xiaotu22/mspm0-ball-balance-car/docs/电赛H题_接线方案_从代码重建.docx

# H题 车载平衡滚球运动控制系统

接 线 方 案
（从固件源码逐条提取，非回忆稿）

主控：MSPM0G3507（逐飞核心板 + 拓展板）
依据：firmware_car\project\user\src\*.c 逐文件核对
整理日期：2026-10-15 修订：2026-10-17（循迹改为七路灰度）

说明：本文档由固件源码反推生成，不依赖任何历史文稿。每个引脚都能在代码里找到出处，并在各表「代码出处」列标明。若实物接法与本文不符，以代码为准 —— 因为最终决定行为的是代码。

# 一、引脚分配总表

模块 | 信号 | MCU 引脚 | 代码宏 | 备注
调试串口 UART0 | TX | A10 | UART0_TX_A10 | 115200，接 USB-TTL 看 printf
| RX | A11 | UART0_RX_A11
K230 视觉 UART2 | TX→K230 | B15 | UART2_TX_B15 | 115200，发命令给 K230
| RX←K230 | B18 | UART2_RX_B18 | ⚠️ 原设计 B16，B16 已确认物理损伤，改走 B18
TB6612 左轮 | PWM | A0 | PWM_TIM_A0_CH0_A0 | 10 kHz
| IN1 | B13 | MOTOR_L_IN1
| IN2 | B12 | MOTOR_L_IN2
TB6612 右轮 | PWM | A1 | PWM_TIM_A0_CH1_A1 | 10 kHz
| IN1 | B2 | MOTOR_R_IN1
| IN2 | A13 | MOTOR_R_IN2
TB6612 STBY | 使能 | （硬件拉高） | 代码不驱动 | ⚠️ 必须外部拉高，否则电机不动
摆杆舵机 | PWM | B3 | PWM_TIM_A1_CH1_B3 | 50 Hz；⚠️ 文件头注释写 B4 是旧值，代码已切 B3
七路灰度循迹 ★当前 | CH1~CH7 | B17 A17 A16 B20 B25 A24 A25 | ir7_pin[7] | 主板灰度口 P14 第 2~8 脚（第 1 脚 B18 被 K230 占）；压黑线=高
（已弃用）六路循迹 | SCL | B8 | SENSOR_6CH_SCL | 幻尔 I2C 0x5C，已拆；代码 LINE_SRC_6CH=0 关掉
OLED SSD1306 | SCL | B6 | OLED_SCL_PIN | 软 I2C；无屏也不死机
| SDA | B5 | OLED_SDA_PIN
编码器 左轮 | A 相 | B10 | ENC_L_A | EXTI 双边沿，4 倍频
| B 相 | B9 | ENC_L_B
编码器 右轮 | A 相 | B11 | ENC_R_A
| B 相 | B7 | ENC_R_B
按键 启动/急停 | — | A30 | KEY_PIN | 上拉，按下=低；空闲短按启动、运行中=急停
按键 模式 + | — | B1 | KEY_MODE_UP | 上拉，按下=低
按键 模式 − | — | B0 | KEY_MODE_DN | 上拉，按下=低
按键 题6目标 | — | A31 | KEY_TGT | 上拉，按下=低；+25px/次
LED / 蜂鸣器 | — | A14 | LED_PIN | ⚠️ 同脚！只钉低，禁止翻转，否则一直响

⚠️ 未接线的模块：QMM01 / CY-Z 陀螺仪（UART1 为 A8/A9）

代码里 qmm01.c 存在，但 main.c 里既没有 qmm01_init() 也没有 qmm01_poll() —— 陀螺仪在当前固件中完全未启用，因此实物可以不接。若将来要用，接 UART1：TX=A8、RX=A9，115200。

# 二、分模块接线明细

## 2.1 电源（最容易出事的一环）

• 舵机走独立 5V，电流余量 ≥3A —— 严禁与逻辑 5V 共用（舵机堵转瞬间会把 MCU 拉复位）。

• 所有电源必须共地：核心板 GND ↔ 拓展板 GND ↔ 电池负极 ↔ 舵机电源负极。

• 电机 VM 接电池正极（7~12V），逻辑 5V/3.3V 由拓展板稳压供给。

• 实测提示：电机满 duty(10000) 时左右轮各约 350 rpm。

## 2.2 TB6612 电机驱动

左轮：PWMA=A0、AIN1=B13、AIN2=B12

右轮：PWMB=A1、BIN1=B2、BIN2=A13

STBY：代码不驱动，必须外部拉高（接 3.3V 或 5V），否则 TB6612 输出全关、电机不动。

⚠️ 换向前必须先刹车 ≥10 ms（MOTOR_REVERSE_BRAKE_MS = 10），这是硬件红线，代码已实现保护。

极性：MOTOR_L_POL = +1、MOTOR_R_POL = +1。即 duty 为正时两轮都前进；右轮不取负。

## 2.3 摆杆舵机

信号线接 B3（TIM_A1_CH1），50 Hz PWM。

脉宽换算：duty = 脉宽(µs) × 10000 ÷ 20000，分辨率 2 µs/LSB。

中位：750 duty（=1500 µs）。软件中位 SERVO_MID_VISION = 1726（落地精标值）。

⚠️ servo.c 第 4 行文件头注释写的是 B4，那是切换前的旧值，第 12 行实际代码已是 B3。以 B3 为准。

## 2.4 七路灰度循迹（当前使用 · 数字量）

【接线】7 根信号线接主板灰度口 P14 的第 2~8 脚 —— 第 1 脚 B18 已被 K230 的 RX 占用，跳过它。

CH1=B17 CH2=A17 CH3=A16 CH4=B20 CH5=B25 CH6=A24 CH7=A25

官方端口表顺序：ADC-B18 / B17 / A17 / A16 / B20 / B25 / A24 / A25（本表取后 7 个）

【极性】压黑线时该路输出【高】电平 —— IR7_ACTIVE_LOW = 0（荣洋 rydz 模块 raw 实测铁证，黑底/黑线/抬高 raw 全 1，白底 raw 全 0）。

【位置】权重 {-3,-2,-1,0,+1,+2,+3}（左负右正），加权均值 ×50 → ±150，与旧六路同量纲。

权重中间那个 0 就是中心通道（CH4）—— 7 路奇数，正好有一路压在线上正中。

【起停线】n ≥ 5 路同时为黑 = 起停胶带，pos 冻结、不算丢线（IR7_TAPE_N = 5）。

【空载安全】7 个脚全做上拉输入 —— 线拔掉时读到高，不会误判成"压线"。

【工程取舍】数字量只有 通/断 两态：单路压线时 pos 只取 0 / ±50 / ±100 / ±150 这 7 个值，相邻两路同压才出现 25/75/125 的中间值。

→ 直道上轻微左右摆是分辨率极限，调参治不了；根治要换"带模拟量输出"的模块 —— 代码里 ADC 分支（LINE_SRC_6CH=0 + IR7_DIGITAL=0）已写好，插上即可用。

【已弃用】幻尔六路 I2C 模块（SCL=B8 / SDA=B26，地址 0x5C，模拟量亚灯插值）已拆除。回滚办法：把 LINE_SRC_6CH 改回 1，那段代码与校准逻辑都还完整留着。

## 2.5 OLED 计时屏

SCL = B6，SDA = B5，软 I2C，SSD1306 128×64。

尺寸 0.96 寸 —— 题纸要求显示屏 ≤2 英寸，符合。

无屏时不影响运行（初始化失败不卡死）。

## 2.6 编码器

左轮：A=B10、B=B9；右轮：A=B11、B=B7。

四路都注册 EXTI 双边沿中断，软件状态机做 4 倍频解码。

每圈 1560 脉冲 = 13（线）× 30（减速比）× 4（倍频）。

ENC_L_SIGN = ENC_R_SIGN = +1（A06 实测改案：R 通道前进即为正）。

## 2.7 按键面板（四键）

A30 = 启动/急停（KEY_PIN）

B1 = 模式 +（1→6 循环）

B0 = 模式 −（6→1 循环）

A31 = 题6 目标位置步进（+25 px/次，超过 +150 回到 −150）

四个键都是上拉输入：未按 = 高电平，按下 = 低电平。30 ms 消抖，松开沿判定。

## 2.8 K230 视觉链路

MSPM0 侧：UART2，TX = B15，RX = B18，115200。

对接方式（按丝印 IO 口，不要用排针序号）：

K230 IO3 (TX1) → MSPM0 B18 (RX)

K230 IO4 (RX1) → MSPM0 B15 (TX)

GND 共地

⚠️ 必须接 B18，不要接 B16 —— B16 已确认物理损伤。

协议（当前实装，见 comm.c:4）：

下行 $V,err,status*HH\r\n 定长 14 字节 —— err = 球心 x − 320（像素，左负右正）；status：0=丢球 1=线 2=目标

上行 $C,mode,p1,p2*HH\r\n 定长 17 字节 —— MSPM0 发命令给 K230

XOR 校验；age ≥ 300 ms 判掉线（判定在上层，不在 comm 层）

# 三、上电初始化顺序（不许乱改）

main() 里的顺序是有原因的，特别是前两条：

序 | 调用 | 说明
1 | clock_init(SYSTEM_CLOCK_80M) | 系统时钟 80 MHz
2 | debug_init() | 调试串口 UART0
3 | motor_init() | ★ 必须紧跟 debug_init！复位后引脚浮空约 400ms，TB6612 输入乱飘会上电猛转；提前接管把窗口压到 ~1ms
4 | gpio_init(LED_PIN=A14) | 钉低，与蜂鸣器同脚
5 | gpio_init(KEY_* ×4) | A30 / B1 / B0 / A31
6 | oled_i2c_init() | B6/B5
7 | servo_init() | ★ 必须排在 motor_init 之后：上电先输出中位脉宽防猛冲
8 | comm_init() | K230 串口 UART2
9 | gpio_init(ir7_pin ×7) | 七路灰度：7 脚全上拉输入（★当前；六路分支为 sensor_6ch_init）
10 | system_delay_ms(3000) | 3 秒准备时间
11 | pit_ms_init ×3 | PIT_G0 编码器采样 / PIT_G7 控制环 / PIT_G6 外挂停车

定时器分配：PIT_G0 = 10ms 编码器采样；PIT_G7 = 10ms 控制环；PIT_G6 = 外挂停车计时（独立，不占控制环）。

# 四、禁用引脚（绝对不要占用）

以下引脚在逐飞核心板/拓展板上另有用途，接了会出问题：

A3 A4 A5 A6 A19 A20 A21 A23

另外 A14 特殊：它是板载 LED 与蜂鸣器的共用脚。代码只做 gpio_init 钉低，禁止任何电平翻转 —— 一旦翻高，蜂鸣器就会一直响。

# 五、上电前核对清单

1. TB6612 的 STBY 已外部拉高（代码不管，忘了电机就不动）

2. 舵机独立 5V 供电、电流余量 ≥3A，且与逻辑共地

3. K230 的 RX 接在 B18 上，不是 B16

4. 舵机信号接 B3，不是 B4（文件头注释是旧值）

5. 四个按键都是上拉输入（未按=高），没有接成下拉

6. A14 没有任何外部上拉/驱动，避免蜂鸣器常响

7. 七路灰度 7 根线接 P14 第 2~8 脚（CH1=B17 … CH7=A25），第 1 脚 B18 必须留给 K230 的 RX

8. 所有 GND 已共地

9. QMM01 陀螺仪可以不接（代码未启用）；若接则 UART1 A8/A9

# 六、每条引脚的代码出处

引脚 | 出处 | 宏名
A0 / A1 | motor.c:13,17 | MOTOR_L_PWM / MOTOR_R_PWM
B13 / B12 / B2 / A13 | motor.c:14,15,18,19 | IN1/IN2 ×2
B3 | servo.c:12 | SERVO_PWM_PIN（文件头 B4 是旧注释）
B17/A17/A16/B20/B25/A24/A25 | main.c:278 | ir7_pin[7]（P14 灰度口第 2~8 脚）
B8 / B26 | sensor_6ch.c:15,16 | SENSOR_6CH_SCL / SDA（六路已弃用，留档）
B6 / B5 | oled_i2c.c:11,12 | OLED_SCL_PIN / SDA_PIN
B10/B9/B11/B7 | main.c:145-148 | ENC_L_A/B, ENC_R_A/B
A14 | main.c:39 | LED_PIN
A30/B1/B0/A31 | main.c:754-757 | KEY_PIN / KEY_MODE_UP / KEY_MODE_DN / KEY_TGT
B15/B18 | comm.c:243 | uart_init(UART_2, ...)
A8/A9 | qmm01.c:14,15 | QMM01_TX_PIN / RX_PIN（未启用）
A10/A11 | zf_common_debug.h:43,44 | DEBUG_UART_TX/RX_PIN
PIT_G0/G7/G6 | main.c:178-180 | PIT_ENC/CTRL/STOP_TIMER

—— 本文档由代码反推生成，若与实物不符请以代码为准，并回头修正代码注释。
