xiaotu22/mspm0-ball-balance-car/images/03_俯拍.jpg

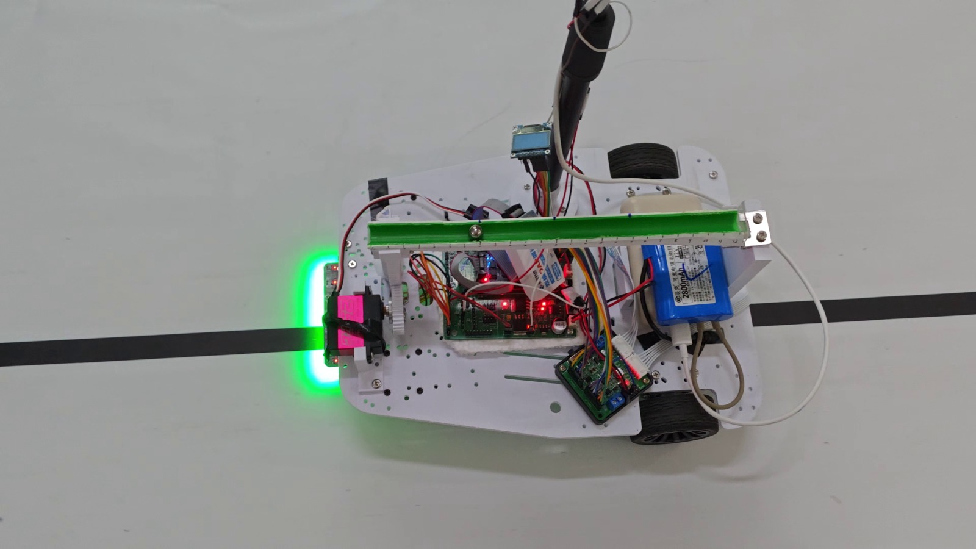
images/03_俯拍.jpg
