xiaotu22/mspm0-ball-balance-car/images/04_侧面.jpg

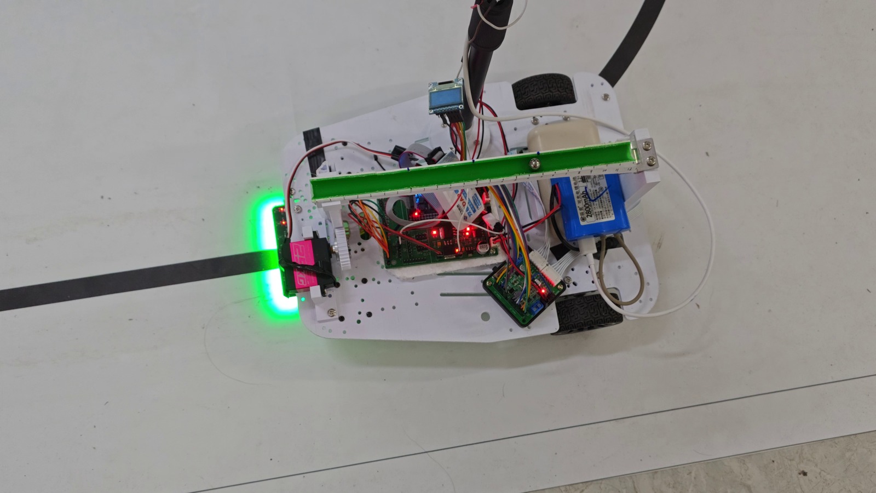
images/04_侧面.jpg
